lyy622516-web/clock-module/设计报告/48MHz 1分4 时钟信号源模块技术方案与设计报告 龙彦宇 20261021.docx

密 级:内部、华为公司

编 号: CRFICS_FRPT03_20261015

48MHz 1分4 时钟信号源模块技术方案与设计报告

龙彦宇

射频集成电路与系统研究中心

电子科技大学信息与通信工程学院

2026年10月15日

Revision History

Version # | Author | A. Description Of Change B. Summary of Review | Issued By / Date
1.0 | 龙彦宇、文光俊 | 初稿 | 2026年09月20

# 中文摘要（给出关键词）

关键词：

# 英文摘要（给出关键词）

Keywords:

# 一、48MHz时钟参考信号源模块应用场景及研制背景

## 1.1 48MHz时钟参考信号源模块应用场景及研制背景

本模块服务于FTTx（FTTH、FTTB、FTTR等的统称，Fiber to the x）与超高频(Ultra-High Frequency-UHF) RFID融合的无源物联系统的相干增强验证实验。在该类系统中，无源超高频RFID标签（以下简称标签）的接收灵敏度与上行链路预算是制约标签识别距离的关键因素，提升端机向标签方向发射的射频信号强度是增大标签到端机通信距离的有效途径：采用多台超高频无源物联可重构端机（以下简称端机）分布式同时发射射频信号、在目标位置的标签处实现射频信号相干功率合成，可提升目标位置处的接收功率，进而提升系统的覆盖能力与吞吐容量。

设两台端机的载波频率分别为f₁、f₂，初始相位分别为φ₁、φ₂，定义载波频差Δf=f₁−f₂与初始相位差Δφ₀=φ₁−φ₂，则两路发射射频信号的相对相位可表示为Δφ(t)=2πΔf·t+Δφ₀。该式表明：只要Δf≠0，两路信号的相对相位就不会保持固定，而是随时间持续旋转，合成信号幅度随之呈现“增强—相消—增强”的周期性变化，即拍频现象；此时即使某一瞬间两路恰好同相，经过一段时间后也会漂移至90°、180°、270°，无法形成稳定的相干增强。

端机的射频本振由各自板载晶振经锁相环（PLL）产生。若两台端机分别使用独立晶振，即使通过上位机软件配置到同一射频频点，其实际输出频率仍会受晶振频偏、锁相环锁定误差与温度漂移的影响而产生差异，Δf难以控制到足够小，合成增益将随时间周期性起伏。因此，相干增强验证模式下各端机必须共用同一个48MHz参考时钟源。

针对分布式多端机相干信号增强验证实验任务需求，特设计研制FTTx-UHF RFID融合超高频无源物联可重构端机在相干增强验证模式所须的外挂式48MHz参考时钟信号源模块。模块内部产生高频率稳定度、低相位抖动的48MHz削顶正弦（Clipped Sine）信号（基准晶振信号），经一分四Buffer扇出四路同频等幅时钟信号输出（SMA接口）。将48MHz参考时钟信号源模块中4路时钟信号输出端口通过等长同轴电缆与四个端机的外时钟信号输入端口（SMA接口）互联，能同时为四个独立端机输入相参的48MHz 时钟信号（作为其FM13RD1616 超高频RFID 读写芯片中PLL的晶振信号），在四个端机中PLL配置参数等相同条件下，实现分布式布置的4个端机发射的射频信号同频率。

各端机接入公共时钟信号源解决了各端机发射的射频信号“同频”问题，但不保证各端机中锁相环输出的射频信号初相一致（各端机所接时钟信号之间的相位差，以及锁相环锁定时间差、分频比与链路时延差将导致各端机发射的射频信号之间存在随机的相位差），即分布式各端机发射的射频信号同频但不同相（彼此存在相位差）。各端机发射的射频信号初始相位之间的误差，可通过调节端机中射频发射链路中插入的外挂式6bits射频移相器的移相量实现补偿，解决各端机发射的射频信号相位相同问题。

本模块设计采用TCXO产生48MHz、0.8 Vp-p削顶正弦信号作为基准时钟信号，输入1-4 Buffer （一分四式时钟信号分配电路）后，扇出4路同频等幅时钟信号经SMA接口输出。采用低噪声低压差线性稳压器LDO给TCXO、1-4 Buffer独立供电，降低数字噪声、电源噪声等耦合到48MHz本振信号频段，提升时钟参考信号的频谱纯度。

## 1.2 48MHz时钟参考信号源模块功能

本模块功能是产生一路高频率稳定度、低相位抖动的48MHz Clipped Sine信号，经1-4 Buffer后扇出4路同频等幅时钟信号经SMA接口输出。

应用场景要求的本模块功能如下：

1) 独立输出四路48MHz Clipped Sine信号（与各端机中内置的晶振信号特性相同），四路输出的时钟信号频率相同、幅度相等，各时钟信号间的相位差（时间差）尽可能小；
2) 外部直流电源（5V适配器）供电；
3) 独立封装成型。

## 1.3 48MHz时钟参考信号源模块技术指标

拟研制的48MHz时钟参考信号源的主要技术指标如下表1-1所示。

表1-1 48MHz时钟参考源模块技术指标要求

性能参数 | 指标值 | 说明
时钟频率 | 48 MHz | 频率精度由YXC-YSO510TP48M TCXO 性能决定
时钟频率稳定度 | ±2.5ppm
时钟信号波形 | 削顶正弦（Clipped Sine） | 0.8 Vp-p
输出时钟信号路数 | 4路 | SMA接口
各输出时钟信号间时间偏斜量 | 200ps | 由5PB1214 1-4 Buffer芯片性能决定
供电方式 | 5V@1A | USB
工作温度范围 | -55C°~+85C°
贮存温度范围 | -65C°~+150C°

# 二、48MHz时钟参考源模块技术方案及工作原理

## 2.1 48MHz时钟参考源模块总体技术方案

设计的48MHz时钟参考源模块电路架构如图2-1所示，其由48MHz温补晶体振荡器（Temperature Compensated Crystal Oscillator-TCXO）、1:4时钟分配芯片、专用低压差线性稳压器（Low Dropout Regulator-LDO）及输出连接器等构成：48MHz TCXO为频率基准单元，输出0.8 Vp-p的削顶正弦波；5PB1214时钟分配芯片为分配单元，将一路参考信号一分四后送至输出连接器；两片IBSP3030超低噪声LDO为供电单元，分别为TCXO与时钟分配芯片提供低噪声供电。

图2-1 48MHz时钟参考源模块总体技术方案框图

本模块的参考信号链路与供电链路相互独立、各自成链。参考信号链路的流程为：外部直流经直流输入连接器与输入滤波网络送入模块，经两片IBSP3030超低噪声LDO分别稳压后为TCXO与5PB1214时钟分配芯片供电，TCXO起振后输出0.8 Vp-p的削顶正弦（Clipped Sine）参考信号，该信号经隔直与匹配网络送入5PB1214的参考输入端，经芯片内部的输入缓冲级、分配网络与四路输出缓冲级处理后一分四，四路等幅同相的48MHz参考信号分别经隔直元件与SMA连接器输出，供各端机的参考输入端使用。

供电链路的流程为：外部直流经直流输入连接器与输入滤波网络后，分别送入两片IBSP3030的输入端，两片LDO各自稳压后输出3.3 V，其中一片只向TCXO供电，另一片只向5PB1214供电，两路供电在输入滤波、输出储能与接地回流路径上相互独立，并仅在单点实现参考地连接，以避免数字噪声与电源噪声在模块内部形成共地耦合。

本模块的上电与工作流程如下：

（1）外部直流接入后，输入滤波网络对电源纹波与高频噪声进行初步抑制，两片IBSP3030同时启动并输出两路3.3 V电压；

（2）TCXO在获得稳定供电后起振，经内部温度补偿网络校准后输出48MHz、0.8 Vp-p的削顶正弦参考信号；

（3）参考信号经隔直与匹配网络送入5PB1214的参考输入端，经芯片内部缓冲与分配后由四个输出端口等幅同相输出；

（4）四路输出分别经隔直元件与SMA连接器送至各端机的参考输入端，各端机关断板载晶振输出并将该外部参考接入锁相环（Phase Locked Loop-PLL）的参考输入端，各端机据此获得同频的射频载波。

本模块的对外接口与信号定义如下表2-1所示。

表2-1 48MHz时钟参考源模块对外接口与信号定义

接口 / 信号 | 类型 | 电平 / 形式 | 功能说明
直流输入接口 | 电源输入 | 外部直流，电压范围按IBSP3030的输入范围与端机可用电源确定 | 模块供电输入，经输入滤波网络后分别送入两片IBSP3030
参考输出SMA1～SMA4 | 射频输出 | 48MHz、0.8 Vp-p削顶正弦、50 Ω | 四路等幅同相参考输出，供各端机参考输入端使用

## 2.2 48MHz Clipped Sine参考信号的产生

参考信号由温补晶体振荡器（TCXO）产生。TCXO利用石英晶体的谐振特性获得稳定的48MHz振荡频率，并通过内置温度补偿网络减小环境温度变化引起的频率漂移。其输出为削顶正弦波，时域表达式为

v(t)=A cos(2πf_0 t+φ_0 )

式中A为输出幅度，f₀为输出频率（48MHz），φ₀为初始相位。

温补晶体振荡器的频率稳定度由石英谐振器与温度补偿网络共同保证。石英谐振器的谐振频率由晶体切型、尺寸与电极结构决定，其频率—温度特性呈三次曲线，在宽温区内存在数十ppm量级的频率漂移；温度补偿网络将环境温度经热敏元件转换为补偿电压，该电压作用于与晶体串联的变容二极管，通过改变变容二极管的结电容微调谐振回路的等效电抗，对频率—温度特性曲线进行分段拟合与抵消，使振荡频率在−40～+85 ℃温区内保持在±1.0 ppm以内。振荡电路起振后，振荡信号经内部缓冲级放大与限幅后输出，由于输出级的驱动电流受限、输出摆幅同时受电源轨与器件线性工作区限制，波形在波峰与波谷处被削平，形成削顶正弦波。

选用削顶正弦波而非方波或纯正弦波作为参考输出形式，是由端机参考输入端的接口要求决定的：方波信号含有丰富的高次谐波，经端机内部链路后会引入额外的杂散与相位抖动；纯正弦波的输出摆幅与驱动能力有限，经电缆传输后难以保证端机参考输入端的电平要求；削顶正弦波在保留接近正弦的基波成分的同时具有较大的输出摆幅与较强的驱动能力，与端机参考输入端的接口形式一致。

与理想正弦波相比，削顶正弦波的波峰与波谷被削平，因此含有奇次谐波分量，可展开为

v(t)=a_1 cos(2πf_0 t)+a_3 cos(6πf_0 t)+a_5 cos(10πf_0 t)+⋯

式中a₁、a₃、a₅分别为基波与各次谐波的幅度：基波幅度最大，谐波幅度随次数升高而迅速减小。由于参考链路传输的是小幅度模拟信号，谐波成分与基波幅度的关系对分配环节较为敏感，因此分配前后应避免引入非线性与明显的幅度衰减。削顶正弦波示意图如图2-2所示。

削顶正弦波的谐波成分与基波幅度的相对关系，决定了分配环节所能容许的幅度衰减与非线性程度。分配芯片的输入级对输入信号幅度存在一定的工作范围：输入幅度过低会使输出端的信噪比恶化，输入幅度过高或波形在分配前后被再次削顶则会引入额外的奇次谐波、恶化频谱纯度。因此，参考信号在送入分配芯片之前须经隔直与匹配网络，使分配芯片输入端的信号幅度落在其削顶正弦输入所要求的范围以内。

图2-2 削顶正弦波时域波形与谐波分量示意图

## 2.3 参考信号的等幅同相分配

5PB1214时钟分配芯片支持削顶正弦直接输入，可直接完成参考信号的一分四分配。设四路输出分别记为i = 1、2、3、4，其表达式为

5PB1214为1:4时钟分配芯片，其内部由输入缓冲级、内部分配网络与四路输出缓冲级构成。参考信号由参考输入端进入芯片后，先经输入缓冲级完成阻抗变换与电平定标，再由内部分配网络分为四路，分别送入四个结构相同、参数一致的输出缓冲级，经驱动后从四个输出端口输出。由于四路输出由同一片芯片内部、从同一路参考信号分出，并共用同一内部偏置，其频率完全相同，四路之间不存在频率偏差，相对相位不随时间漂移；各输出通道之间的传播延迟差异（即输出间偏斜）主要来源于芯片内部的器件匹配偏差与工艺离散性，在相同负载与相同走线几何条件下，四路输出的幅度偏差与相位偏差可以控制在很小的范围内。

v_i (t)=A_i cos(2πf_0 t+φ_i )

四路输出应满足等幅同相条件

A_i =A,φ_i =φ_0

由于四路输出由同一片分配芯片、从同一路参考信号分出，其频率完全相同，四路之间不存在频率偏差，相对相位不随时间漂移。四路之间的幅度差异与相位差异主要由分配芯片各输出通道的增益偏差与输出间偏斜决定。选用输出间偏斜很低的5PB1214，并保证各输出走线几何条件一致，即可获得良好的等幅同相特性。

为使四路输出满足等幅同相条件，分配环节按下述步骤设计与实施：

（1）选择输出间偏斜指标优良的5PB1214作为分配单元，使芯片内部引入的路间偏差尽可能小；

（2）四路输出采用相同型号、相同容差的隔直元件，并按相同拓扑连接，避免因元件离散性引入额外的幅度与相位差异；

（3）四路输出走线在同一层、等长、等宽布置，并对相邻走线设置地线隔离，使四路走线的分布参数一致；

（4）四路输出端口采用相同的SMA连接器与相同的端接方式，测量时未接入仪器的端口一律以50 Ω匹配负载端接，避免开路或短路引起的反射；

需要说明的是，四路输出之间的相位偏差最终体现为各端机参考输入的到达时刻差，其与射频载波相位差的换算关系为：相位差（度）等于时间偏差（ps）乘以360°，再乘以射频频率（Hz），再除以10的12次方。以48MHz参考信号50 ps的输出间偏斜为例，该偏斜在48MHz参考上对应约0.864°的相位偏差，经端机内部锁相环倍频至922.5 MHz后对应约16.6°的射频相位偏差，该固定相位偏差可由各端机所接6bit数控射频移相器的移相量补偿。

## 2.4 专用LDO独立供电

为避免数字噪声与电源噪声破坏削顶正弦参考信号的频谱纯度，本模块采用两片IBSP3030超低噪声LDO，分别独立为TCXO和5PB1214时钟分配芯片供电。两路供电在输入滤波、输出储能与接地回流路径上相互独立，并仅在单点实现参考地连接。LDO的电源抑制比（Power Supply Rejection Ratio-PSRR）越高，电源纹波经LDO传递到输出端的幅度越小，其关系为

ΔV_o ut=(ΔV_i n)/(10^(PSRR/20))

IBSP3030在100 kHz处的PSRR可达95 dB，可将电源噪声大幅衰减，从而减小对参考信号相位噪声的影响。

电源噪声通过传导耦合与共地阻抗耦合两条路径影响参考信号的频谱纯度。传导耦合路径为开关电源或数字电路的纹波经供电网络直接传递到TCXO与分配芯片的电源引脚，在振荡回路中形成寄生调相；共地阻抗耦合路径为数字电路的开关电流流过公共地线上的寄生电感与电阻，在两地之间形成电位差，该电位差经器件的接地引脚进入振荡回路。两片IBSP3030分别独立供电，使TCXO与分配芯片的供电支路在物理上分开，噪声源与敏感电路之间不再共用同一个电源回路；两路供电仅在单点实现参考地连接，避免了公共地线上形成环流。

专用LDO对电源噪声的抑制能力由电源抑制比（Power Supply Rejection Ratio-PSRR）衡量，其以分贝表示为输入纹波幅度与输出纹波幅度之比的对数值的相反数，PSRR越高，同一输入纹波下传递到输出端的纹波幅度越小。IBSP3030在100 kHz处的PSRR可达95 dB，可将电源噪声大幅衰减，从而减小对参考信号相位噪声的影响。

## 2.5 外挂48MHz同源参考工作原理

只考虑两台端机各自的连续载波，可以分别表示为

s_1 (t)=A_1 cos(2πf_1 t+ϕ_1 )

s_2 (t)=A_2 cos(2πf_2 t+ϕ_2 )

其中, A_1 、A_2 分别为两路载波幅度， f_1 、f_2 为两路载波频率， ϕ_1 、ϕ_2 为初始相位。两路信号合成以后，关键不再只是各自的绝对相位，而是两路信号之间的相对相位。

为了描述两路载波的差异，定义载波频差和初始相位差分别为

Δf=f_2 -f_1

Δϕ_0 =ϕ_2 -ϕ_1

那么随时间变化的相对相位为

Δϕ(t)=2πΔf t+Δϕ_0

这个公式说明：只要 Δf≠0 ,两路载波的相对相位就不会保持固定，而是会随着时间持续旋转。也就是说，即使两台端机在某一个瞬间恰好同相，经过一段时间以后也会变成90°、180°、270°，随后再次回到360°，周而复始。

对于射频相干合成，更直接的幅度关系为

A_Σ (t)=√(A_1^2 +A_2^2 +2A_1 A_2 cos[Δϕ(t)])

若用功率表示，则可以写成

P_Σ (t)=P_1 +P_2 +2√(P_1 P_2)cos(2πΔf t+Δϕ_0 )

因此，当相对相位接近0°时，两路发射射频信号同相叠加，合成功率达到较大值；当相对相位逐渐接近180°时，两路发射射频信号发生相消，合成功率降低；继续演化到360°后又重新同相增强。这样便形成了“增强—相消—增强”的周期性幅度变化，也就是通常所说的拍频现象。

当两路幅度近似相等，即 A_1 =A_2 =A 时，还可以利用三角恒等式将合成信号写成

s_Σ (t)=2Acos(πΔf t+(Δϕ_0)/2)cos(2π(f_1 +f_2)/2t+(ϕ_1 +ϕ_2)/2)

式中第二个余弦项仍然是接近922.5 MHz的高频载波，而第一个余弦项是随 Δf 缓慢变化的幅度因子。如图2-3所示绿色、蓝色和红色波形分别代表端机1的载波、端机2的载波和两台端机的合成信号。

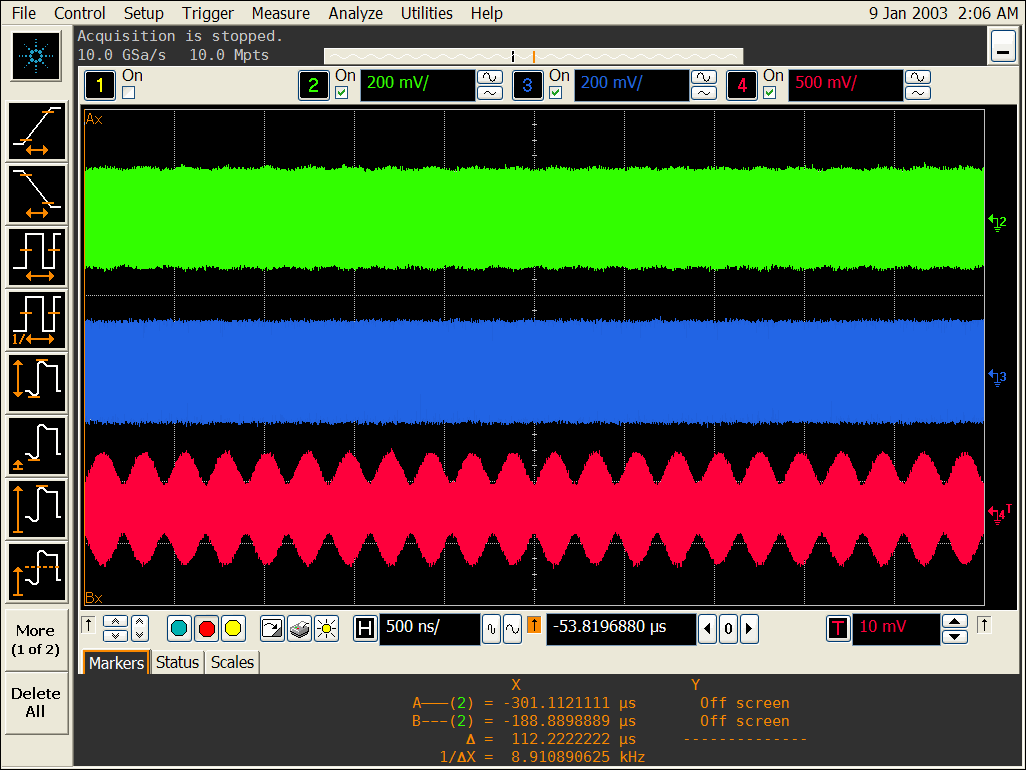
[picture p1: figure]

图2-3 两台端机载波频差引起的拍频现象

端机采用公共48MHz参考时钟的重要意义就在于显著减小不同端机之间的长期频率偏差、使其尽可能为0，但公共参考并不能保证两个端机锁相环输出射频信号的绝对初相天然一致，因此仍需要外挂6bit数控射频移相器进行相位补偿。若两个端机分别使用独立晶振，即使软件配置频点相同，其实际输出频率仍会受晶振频偏和温度漂移影响产生差异。因此，相干增强验证模式下两台端机必须共用一个参考时钟源。

需要指出的是，公共参考源解决的是同频问题，其作用边界在于把各端机之间的载波频差压缩到相干增强实验所允许的范围以内，使两路载波的相对相位在相干时间以内基本保持不变；而两路射频信号到达目标位置处的绝对相位，仍由各端机内部锁相环的锁定过程、分频比、滤波网络、射频电缆与天线的电长度共同决定，属于同相问题，须由各端机所接6bit数控射频移相器解决。

## 2.6 供电能力与功耗分析

本模块的供电结构如图2-1所示：外部直流经USB接口、输入保护与滤波网络后得到内部的VBUS电源，VBUS同时送入两片IBSP3030的输入端，由两片LDO各自独立稳压输出3.3V——U1的输出（电源网络3V3）只向YSO510TP温补晶体振荡器供电，U2的输出（电源网络VDD）只向5PB1214时钟分配芯片供电，两路供电在模块内部互不交叉。该供电结构是否可行，需从压差余量、负载电流与输入电流三个方面核算。

本模块的输入输出电压差为1.7V，而IBSP3030在200mA输出时的典型压差约350mV，1.7V的余量约为该压差的4.8倍；即使计入器件离散性、低温与大电流下压差增大的影响，两片LDO在全工作温度与全负载范围内仍工作在线性调整区，不会进入压差限制状态，因此3.3V输出可以保持稳定，模块无需在USB输入端另加一级稳压。LDO的耗散功率等于压差与输出电流之积，按后述负载电流估算，U1的耗散约6mW、U2的耗散约20～24mW，合计不超过约30mW，两片LDO均不需要额外的散热措施。

两片LDO的负载电流均远低于其200mA的输出能力。TCXO一侧，YSO510TP削顶正弦版本的最大工作电流约3.5mA；缓冲器一侧，5PB1214在3.3V电源、26MHz输入、四路输出全部使能的条件下，电源电流的典型值为11.34mA、最大值为14.06mA（见5PB1214数据手册第5页）。需要指出的是，上述数据是手册在26MHz、四路使能条件下的测试值，本模块工作在48MHz，且外接负载为端机参考输入端或仪器输入等高阻负载，实际电流与手册条件并不完全相同，因此14.06mA只能作为量级参考。

两片LDO的输出能力与模块的输入电流不是同一概念。IBSP3030标称的200mA是器件的输出电流上限，并非模块的实际消耗：每片LDO的输入电流约等于其自身负载电流与静态电流（约3.2mA）之和，两片LDO合计的5V输入电流约为两个负载电流之和再加上两片LDO的静态电流，而不会出现“两片LDO各消耗200mA”的情形。按上述手册值估算，模块的供电电流与供电能力如表2-2所示。

表2-2 模块供电电流与供电能力估算（待实测确认）

项目 | 电流 / 供电能力 | 说明
U1负载：YSO510TP（3.3V） | 最大约3.5mA | 削顶正弦输出，依据TCXO数据手册
U2负载：5PB1214（3.3V） | 典型11.34mA；最大14.06mA | 3.3V、26MHz、四路使能条件（数据手册第5页），48MHz下以实测为准
LDO静态电流（2片） | 单片约3.2mA | 依据IBSP3030数据，两片合计约6.4mA
模块5V输入电流（估算） | 约20mA～25mA | 两个负载电流与两片LDO静态电流之和，待实测确认
供电能力 | 5V@1A | USB适配器供电，输入保险丝X1额定1A

由表2-2可见，模块从5V取用的电流仅约20mA～25mA，相对USB 5V@1A的供电能力与输入保险丝X1的1A额定值均有充足余量，USB供电能力不构成该模块的设计约束；本模块的负载为端机参考输入端这类高阻接收端，负载电流很小，供电能力通常不是瓶颈。

# 三、48MHz时钟参考源模块硬件电路设计与主要器件选型

## 3.1 主要器件选型

### 3.1.1 48MHz TCXO（YSO510TP）

本模块选用扬兴科技（YXC）48MHz温补晶体振荡器（TCXO），型号YSO510TP，其主要技术指标如下表3-1所示。

表3-1 YSO510TP 48MHz TCXO主要技术指标

参数 | 指标
输出频率 | 48 MHz
频率稳定度 | ±1.0 ppm（−40～+85 ℃）
输出波形 | 削顶正弦（Clipped Sine）
输出幅度 | 0.8 Vp-p
工作电压 | 3.3 V
封装 | 3.2 mm × 2.5 mm，4 脚表贴
生产商 | 扬兴科技（YXC）

TCXO是本模块的频率基准，其频率稳定度决定了参考信号的长期频率一致性，其相位噪声决定了参考信号的短时抖动。选用内置温度补偿网络的TCXO，可在宽温区内保持较高的频率稳定度，且体积小、功耗低、启动快。

### 3.1.2 5PB1214时钟分配芯片

时钟分配芯片选用瑞萨科技（Renesas）5PB1214，其主要技术指标如下表3-2所示。

表3-2 5PB1214 1:4时钟分配芯片主要技术指标

参数 | 指标
输入频率 | 0–200 MHz
电源 | 2.5 V / 3.3 V
输入 | LVCMOS / Clipped Sine
封装 | 16-pin，2.5 mm × 2.5 mm VFQFPN
生产商 | 瑞萨科技（Renesas）

5PB1214支持削顶正弦直接输入，与本模块所选TCXO的输出波形一致，可直接完成参考信号的一分四分配，无需额外的波形变换，有利于保持小幅度模拟参考信号的完整性。其四路输出在相同负载与相同走线几何条件下具有很低的输出间偏斜，可保证各输出路之间的等幅同相特性。

### 3.1.3 IBSP3030专用供电LDO

TCXO与时钟分配芯片的专用供电LDO选用英彼森半导体（Inbisen）IBSP3030，其主要技术指标如下表3-3所示。

表3-3 IBSP3030超低噪声LDO主要技术指标

参数 | 指标
输入电压 | 设计建议 2.4～20 V
输出电压 | 0.5～16 V 可调
输出电流 | 200 mA
静态电流 | 约 3.2 mA
PSRR @100 kHz | 95 dB
PSRR @1 MHz | 78 dB
生产商 | 英彼森半导体（Inbisen）

IBSP3030具有很高的电源抑制比与很低的输出噪声，适合为TCXO与时钟分配芯片这类对电源噪声敏感的器件供电。专用LDO可以隔离端机内其他电路（尤其是功放、开关电源）的电源噪声，减小其对参考信号频谱纯度与相位噪声的影响。

## 3.2 原理图设计

本模块的原理图采用层次化方式绘制，按功能划分为顶层框图、时钟一分四部分与电源部分：顶层框图页给出模块的对外接口与页间连接关系，时钟一分四部分给出48MHz参考信号的产生、端接、隔直、偏置、分配与输出电路，电源部分给出模块的取电、保护与稳压电路。

### 3.2.1 48MHz时钟参考源模块电路系统顶层框图

48MHz时钟参考源模块的顶层原理图如图3-1所示。顶层原理图由U_POWER与U_48MHz_TCXO两个层次化图页符号构成，不含具体器件，其作用是表述模块的对外接口以及两页之间的电源关系。U_POWER为电源图页，对外引出USB_5V、3V3与VDD三个层次端口，其中USB_5V为模块的外部直流输入端口，3V3与VDD分别为该页中两片IBSP3030稳压后送出的两路独立电源；U_48MHz_TCXO为时钟一分四图页，输入侧接收U_POWER送来的3V3与VDD两路电源，输出侧引出CLKOUT1～CLKOUT4四路48MHz参考信号。

U_POWER的3V3端口与U_48MHz_TCXO的3V3端口相连，作为48MHz TCXO的专用电源；U_POWER的VDD端口与U_48MHz_TCXO的VDD端口相连，作为5PB1214时钟分配芯片的专用电源。

图3-1 48MHz时钟参考源模块顶层原理图

### 3.2.2 48MHz时钟参考源模块电路原理图设计

本模块的具体电路分布在时钟一分四与电源两页原理图中，两页之间只通过3V3、VDD与USB_5V三组层次端口联系，不共用其他信号线。时钟一分四页完成参考信号的产生、端接、隔直、直流偏置、一分四分配与输出连接；电源页完成Type-C取电、过流与浪涌保护、两路独立稳压及输出滤波。

3.2.2.1 48MHz时钟参考源模块时钟一分四原理图

本模块的时钟一分四原理图如图3-2所示，按信号流程可分为参考信号产生、参考信号调理、一分四分配与四路输出四部分。参考信号由48MHz温补晶体振荡器U4（YSO510TP）产生：U4的第4脚（VDD）接3V3端口，第2脚（GND）接参考地，第1脚（NC）悬空，第3脚（OUTPUT）输出0.8 Vp-p的削顶正弦参考信号。TCXO的供电入口处配置C14（10uF）与C15（100nF）两只去耦电容，分别滤除低频纹波与高频噪声，使TCXO的电源引脚获得低阻抗的供电回路；两只电容的接地端与U4的GND引脚就近汇接后接至参考地，避免去耦电流流过公共地阻抗而形成共地耦合。

U4的输出端并联C16（10pF）、R17（10k）与R18（50Ω）三个对地元件：R18为输出端的50Ω负载端接，使削顶正弦输出工作在额定的负载条件下，C16与R17用于抑制输出端的高频耦合与直流漂移。参考信号再经C11（100nF）隔直后送入5PB1214的参考输入端CLKIN（第15脚）；CLKIN端由R11（10k）接至参考地、R16（10k）接至VDD，两只电阻将隔直后削顶正弦信号的直流工作点偏置在VDD的中点，使输入信号的摆幅落在分配芯片输入级的线性工作范围以内，避免因输入电平过低而使输出信噪比恶化、因输入电平过高而使波形在分配前后被再次削顶。

5PB1214（U3）的电源引脚VDD（第2、7、12脚）接VDD端口，三个电源引脚各自就近配置一组1uF与10nF的去耦电容，即C10与C9、C7与C8、C13与C12，并与VDD支路上的C17（10nF）与C18（1uF）共同构成由大到小的多级滤波网络；芯片的GND引脚（第3、9、14脚）接参考地。四个输出使能端OE1（第16脚）、OE2（第1脚）、OE3（第4脚）与OE4（第5脚）分别经R15、R14、R12、R13上拉至VDD，使四路输出通道在上电后即处于开通状态，避免使能端悬空导致输出通道随机关断；OE_OSC（第6脚）在本设计中悬空未接，参考信号由外部TCXO经CLKIN端输入，不使用芯片内部的振荡单元。

四路输出CLKOUT1（第13脚）、CLKOUT2（第11脚）、CLKOUT3（第10脚）与CLKOUT4（第8脚）分别经串联电阻R19、R20、R21、R22（33Ω）引至SMA连接器H1～H4的中心导体（第1脚）。33Ω串联电阻与分配芯片输出端的等效源阻抗共同构成输出端的串联端接，用于抑制输出波形的过冲与振铃，并把分配芯片的输出与外部电缆隔开，减小电缆侧反射对芯片内部电路的影响；四只SMA连接器的两只接地引脚（第2、3脚）直接接至参考地，使四路输出的参考地回路在连接器处就近汇接。

图3-2 48MHz时钟参考源模块时钟一分四原理图

3.2.2.2 48MHz时钟参考源模块电源原理图

本模块的电源原理图如图3-3所示，按功能可分为Type-C取电与保护、两路独立稳压两部分。模块由USB Type-C插座J1取电，插座的两只外壳引脚EH（第13、14脚）接参考地；CC1与CC2分别经R2、R1（5.1k）下拉至参考地，使插座工作在受电（sink）状态。插座的VBUS引脚并接后先经保险丝X1（1A）实现过流保护，再经瞬态电压抑制二极管D1（SMF5.0A）对浪涌电压进行钳位，随后经C1（47uF）与C2（10uF）组成的输入滤波网络得到模块内部的VBUS电源，供两片LDO使用。

两片IBSP3030分别记为U1与U2，采用完全相同的电路结构，仅输出所连接的电源网络不同。以U1为例：输入引脚IN（第1、2脚）、使能引脚EN/UV（第3脚）与电源正常指示引脚PG（第4脚）均接至VBUS，PG经R5（200k）上拉至EN/UV，使LDO在输入电压建立后自行使能；限流设定引脚ILIM（第5脚）接参考地。U1的输出引脚OUT（第10脚）与OUTS（第9脚）并接后经C3（4.7uF）滤波，由端口3V3输出，在时钟一分四页中为TCXO供电；U2的输入支路配有R9（200k）上拉，其输出由端口VDD输出，为5PB1214时钟分配芯片供电。两片LDO的输入滤波电容、输出储能电容与接地回流路径各自独立，仅在参考地处单点汇接，避免两路供电之间通过公共地阻抗形成耦合。

每片LDO的输出电压由SET端（第7脚）的外接网络设定：SET端经R3（33k）接参考地，并在SET端并联C4（4.7uF），用于旁路SET端的噪声、减小SET端噪声对输出电压与输出噪声的调制；U2对应使用R7与C6。电源正常指示的检测门限由PGFB端（第6脚）设定：PGFB端经R4（91k）接输出电压、经R6（10k）接参考地，由两只电阻对输出电压分压，构成电源正常指示的检测门限；U2对应使用R8与R10。两片LDO的电源正常指示端可用于在调试中判断3V3与VDD两路电源是否均已正常建立。

图3-3 48MHz时钟参考源模块电源原理图

## 3.3 PCB板图设计

本模块的PCB为两层板，板尺寸为22 mm×32 mm。板上器件与48MHz参考信号的走线均布置在L1层（顶层），L2层（底层）为完整的地平面，既为L1层的单端50Ω微带走线提供连续的参考地，也兼作模块的屏蔽与回流平面。

模块PCB的顶层版图如图3-4所示。板面按功能分为三个区域：上侧为电源与接口区，USB Type-C插座位于上侧边，其后依次布置输入保护与滤波元件以及两片IBSP3030及其设定、去耦网络，使USB入口到稳压输出的回路尽量短，减小输入回路的环路面积；中部为时钟产生与分配区，48MHz TCXO及其去耦电容、5PB1214及其各路去耦电容集中布置，缩短了TCXO到分配芯片、分配芯片到各去耦电容的距离；下侧与两侧为输出连接区，四只SMA连接器H1～H4分别布置在板的左侧、右侧与下侧边，四路输出由分配芯片的输出引脚经33Ω串联电阻R19～R22就近引出，串联电阻紧靠分配芯片放置，走线短而直，以减小走线引入的附加损耗、路间串扰与时延差。板面大面积铺参考地，并在SMA连接器的接地引脚与分配芯片的接地引脚周围布置接地过孔，使四路输出的接地回流路径尽量短。

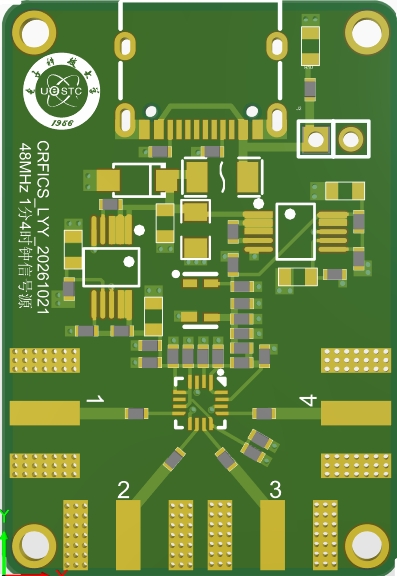
[picture p2: figure]

图3-4 48MHz时钟参考源模块PCB顶层版图

模块PCB的底层版图如图3-5所示。L2层为完整的参考地平面，除连接L1层与L2层的接地过孔外不布置信号走线，从而保证L1层每一段时钟走线的下方均有连续的地平面，避免因参考地不连续引起的阻抗突变与信号反射。底层地平面在SMA连接器与分配芯片的正下方布置了成组的过孔阵列，把L1层的地铜皮、连接器的接地引脚与L2层地平面就近连成同一低阻抗回路，以减小四路输出之间的共地耦合，并为参考信号提供最短的回流路径。

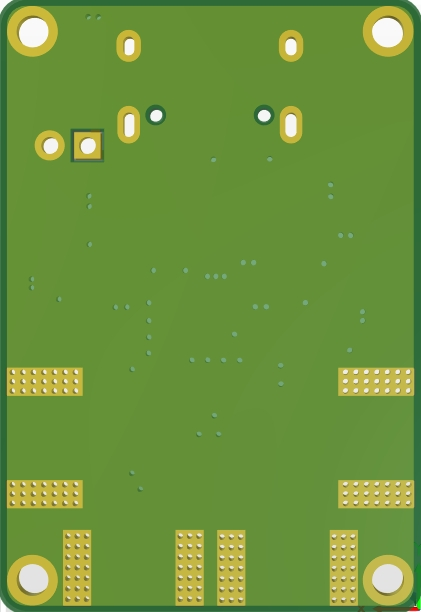
[picture p3: figure]

图3-5 48MHz时钟参考源模块PCB底层版图

模块的层叠结构与厚度如图3-6所示。板材选用Core-034，介质层厚度为0.4064 mm，相对介电常数为4.8，损耗角正切为0.02；L1层与L2层均为1盎司铜，铜厚0.03556 mm；两面的阻焊层厚度均为0.01016 mm。按上述层叠计算，成品板厚约0.5 mm，满足成片厚度不超过0.6 mm的要求。选用较薄的介质与较薄的成品板厚，一方面使L1层50Ω微带线的线宽落在便于加工、焊接与阻抗控制的范围内，另一方面缩短了接地过孔的路径长度，有利于降低四路输出端的接地电感。

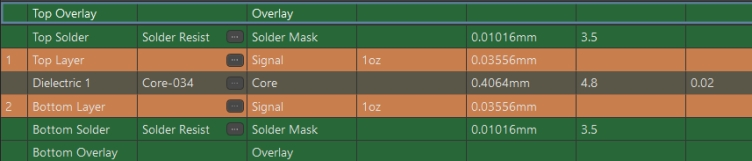
[picture p4: figure]

图3-6 48MHz时钟参考源模块PCB层叠结构

48MHz参考信号的输出走线按单端50Ω阻抗控制。按上述层叠参数计算，L1层单端50Ω微带线的线宽取0.661 mm，走线以L2层地平面为参考面，使四路输出走线的特性阻抗与SMA连接器的50Ω接口相匹配，减小因阻抗失配引起的反射。四路输出从5PB1214的输出引脚经33Ω串联电阻后就近引出至SMA连接器，走线尽量短、尽量直，并保持与相邻走线足够的间距，以减小走线间的串扰与附加时延；由于四只SMA连接器分布在板的三侧，四路走线的长度不能完全相等，其引入的路间时延差以实测值为准，测试时与分配芯片的输出间偏斜一并计入。

# 四、48MHz时钟参考源模块加工与装配方案

## 4.1 加工方案

本模块的加工对象包括印制板（Printed Circuit Board-PCB）、结构件与连接器，其加工方案的确定以原理图与板图定版为前提。

## 4.2 装配方案

# 五、48MHz时钟参考源模块功能与性能调试与测试方案

本模块的调试与测试围绕其作为相干增强验证公共参考源的功能定位展开。模块需要解决的问题是：为多台端机提供频率一致、幅度与相位关系可复现的48MHz参考信号，从而把各端机之间的载波频差压缩到相干增强实验所允许的范围以内。

## 5.1 调测平台与仪器配置

### 5.1.1 测试仪器与设备清单

本模块的输出为小幅度削顶正弦波，测量以频域测量为主、时域测量为辅。所有射频端口均应通过50Ω同轴线缆与SMA转接器连接，并在使用前记录线缆损耗；测量相位关系时应避免使用带宽不足或输入阻抗不匹配的仪器直接跨接。所需仪器设备如下表5-1所示。

表5-1 测试仪器与设备清单

序号 | 仪器 / 设备名称 | 主要技术要求 | 用途
1 | 频谱分析仪 | 频率范围覆盖48MHz，具备相位噪声测量选件 | 输出频率、谐波与杂散测量
2 | 信号源分析仪/相位噪声测试仪 | 支持48MHz载波，偏置频率覆盖1kHz～1MHz | 相位噪声测量，可用带相位噪声选件的频谱分析仪替代
3 | 数字示波器 | 带宽不低于1GHz，不少于4通道，通道间偏斜可标定 | 输出幅度、波形与四路输出间相位偏差测量
4 | 矢量网络分析仪 | 频率范围覆盖48MHz附近 | 输出端口回波损耗与路间隔离度测量
5 | 可编程直流稳压电源 | 输出电压覆盖模块输入范围，具备电压与电流读数 | 模块供电与电流、功耗测量

### 5.1.2 被测模块与测试连接关系

被测模块为48MHz时钟参考源模块样机，测试时由可编程直流稳压电源经外部直流输入端供电。四路SMA参考输出中，一路接频率计数器，一路接频谱分析仪或信号源分析仪，两路接数字示波器通道，其余端口以50Ω匹配负载端接，避免开路反射。测量四路输出之间的相位偏差时，四路输出应同时接入示波器的四个通道，并预先完成通道偏斜标定。

本阶段给出测试方案与测量方法，测试连接框图待样机加工与装配完成后补充，图中应标明各仪器型号、线缆编号、端接方式与测试端口。

## 5.2 供电与静态工作点测试

供电部分的测试目标是确认两片IBSP3030能够按设计分别为TCXO与时钟分配芯片提供稳定的3.3V供电，并核验模块整体功耗是否处于预算范围以内。为TCXO与分配芯片独立供电是抑制电源噪声、保证参考信号频谱纯度的关键措施，因此除电压数值外，还须关注输出电压上的纹波与开关噪声。

## 5.3 参考频率与频率稳定度测试

参考频率的准确度与稳定度是本模块最核心的指标。公共参考源的作用是把各端机之间的载波频差压缩到相干增强实验所允许的范围以内，因此除标称48MHz处的频率偏差外，还须考察频率随时间与温度的变化。按照表1-1，参考频率精度由TCXO决定，所选YSO510TP的频率稳定度为±1.0 ppm（−40～+85 ℃），该指标构成本节各测试项目的判据来源。

## 5.4 输出电平与波形质量测试

参考信号的输出电平与波形质量决定了它能否与端机TCXO参考输入端的接口要求相匹配。本模块输出为0.8 Vp-p的削顶正弦波，幅度偏低，测量时应特别注意仪器的输入阻抗与耦合方式，频谱分析仪测量谐波与杂散时应避免输入过载。

### 5.4.1 削顶正弦波形与谐波分量测试

用示波器观察单一周期内的波形形态，确认波峰与波谷被对称削平，无畸变、无自激与明显的幅度抖动。削顶正弦波本身含有奇次谐波分量，其谐波幅度随次数升高而迅速减小，可用频谱分析仪测量二次、三次谐波相对基波的抑制度，作为波形完整性的量化依据。由于参考链路传输的是小幅度模拟信号，谐波成分与基波幅度的关系对分配环节较为敏感，分配前后不应引入额外的非线性与明显的幅度衰减；若测试中发现谐波抑制度明显恶化，应检查分配芯片的输入电平与阻抗匹配状态。

### 5.4.2 四路输出幅度一致性测试

在同一批次、同一示波器设置下测量四路输出的幅度，取最大值与最小值之差作为路间幅度不一致度并以dB表示。等幅是四路输出应满足的条件之一，路间幅度差异主要来源于分配芯片各输出通道的增益偏差与输出走线的不一致。测试结果应记录并作为后续各端机参考输入电平一致性的依据。

## 5.5 四路输出等幅同相特性测试

四路输出之间的相位偏差直接叠加到各端机的参考输入上，进而影响各端机锁相环输出射频信号的初相差异。该偏差量级较小，测量时必须先扣除测量系统本身的通道偏斜，否则通道偏斜会被误判为模块的输出间相位偏差。

## 5.6 相位噪声测试

将任一路参考输出接入具备相位噪声测量能力的仪器，在1 kHz、10 kHz、100 kHz、1 MHz等偏置频率处测量单边带相位噪声。测量前应确认仪器的本底噪声低于被测信号的预期相位噪声，必要时在仪器输入端串联衰减器以保护输入。

## 5.7 端机联调验证测试

模块自身指标合格并不等于公共参考源在系统中有效。公共参考源只解决同频问题，并不能保证两套锁相环输出的射频初相天然一致，因此联调验证的目标是在模块接入两台端机之后，实测其载波残余频差是否已落入相干增强实验所允许的范围。

两台端机共用一个48MHz参考源并配置在同一射频频点，在固定目标接收点、相同测量通路与带宽下测量单路功率，随后两路同时发射，在频谱仪或矢量信号分析仪上观测合成信号包络的拍频周期，据此反推两路端机之间的载波残余频差，并计算相干增强可保持的相干时间。该残余频差的实测结果是判断相干增强可保持时长、进而确定移相码搜索与更新周期的关键输入。

# 六、48MHz时钟参考源模块测试及结果

本模块当前处于方案与工作原理分析阶段，尚未完成样机加工与装配，本章给出测试记录方法与记录表，待样机加工、装配和联调完成后，将每次测试的日期、地点、温湿度、样机编号、软件版本、仪器型号、线缆损耗、频点、功率、RSSI和结论填入测试报告，并附原始数据或截图。

## 6.1 测试记录表

表中空白处为实测填写区，测试时应同时保存仪器截图或原始数据文件，不得以设计值或理论值代替实测记录。

表6-1 供电与静态工作点测试记录表（待测）

测试项目 | 设计要求 / 判据 | 实测值 | 结论 | 备注
直流输入电压 | 按模块输入设计值
TCXO供电电压（IBSP3030输出1） | 3.3 V
分配芯片供电电压（IBSP3030输出2） | 3.3 V
模块总电流 / 总功耗 | 在设计预算范围以内

表6-2 四路输出幅度测试记录表（待测）

输出路 | 实测幅度（Vp-p） | 设计值（Vp-p） | 幅度偏差 | 波形形态 | 备注
输出1 | | 0.8
输出2 | | 0.8
输出3 | | 0.8
输出4 | | 0.8
路间幅度不一致度 | | — | | —

表6-3 相位噪声与杂散测试记录表（待测）

偏置频率 | 独立LDO供电（dBc/Hz） | 直接供电（dBc/Hz） | 备注
1kHz
10kHz
100kHz
1MHz
最大非谐波杂散

## 6.2 测试结论

当前阶段尚未完成样机加工与装配，各项测试数据待样机联调完成后填入上述记录表并据此形成结论。结论中应明确受测样机编号、测试日期、测试地点、仪器型号与校准状态，并对未达标项给出原因定位与下一轮改进措施。

# 七、总结

本模块面向FTTx与超高频RFID融合无源物联系统的相干增强验证需求，研制了一路高频率稳定度、低相位抖动的48MHz公共参考源。模块以YSO510TP温补晶体振荡器为频率基准，输出0.8 Vp-p的削顶正弦波，经5PB1214时钟分配芯片完成一分四分配后通过SMA连接器输出，供多台可重构端机共用；两片IBSP3030超低噪声LDO分别为TCXO与时钟分配芯片独立供电，以减小电源噪声对参考信号频谱纯度与相位噪声的影响。

该方案种公共参考源解决的是相干增强中“同频”的问题。只要两台端机之间存在载波频差，两路发射射频信号的相对相位就会随时间持续旋转，合成信号幅度随之呈现增强—相消—增强的周期性变化，即拍频现象；即使某一瞬间恰好同相，经过一段时间后也会漂移至90°、180°、270°。采用公共48MHz参考能够显著减小不同端机之间的长期频率偏差，但并不能保证两套锁相环输出的射频初相天然一致，因此同频与同相两个问题需分别解决，本模块与外挂6bit数控射频移相器模块配合使用。

本模块目前处于技术方案与工作原理分析阶段，电路原理图与PCB板图尚未绘制，加工与装配方案、样机实测数据待后续补充。

# 附件：引用的技术文献清单

1) 元器件/芯片datasheet清单
（1） 48MHz时钟参考模块datasheet
2) 应用的设计开发平台文档清单
（1） Altium Designer 25
（2） Matlab2016

13 Not for use or disclosure outside CRFICS，SICE，UESTC. except under prior written agreement
