lyy622516-web/clock-module/设计报告/48MHz Clipped Sine 时钟信号产生技术方案与设计报告 井家轩 20260911.docx

密 级

编 号

48MHz时钟参考源模块技术方案与设计报告

姓 名

井家轩

射频集成电路与系统研究中心

电子科技大学信息与通信工程学院

2026年09月11日

Revision History

Version # | Author | A. Description Of Change B. Summary of Review | Issued By / Date
1.0 | 井家轩 | 初稿 | 2026年09月10日

目 录

# 中文摘要（给出关键词）

# 英文摘要（给出关键词）

# 一、外挂时钟参考模块功能与技术指标要求

本模块的功能是产生一路高频率稳定度、低相位抖动的 48 MHz Clipped Sine（削顶正弦）参考时钟信号，并将其等幅同相地分配到各端机的参考输入端。

本模块要实现的具体功能及应用场景与要求如下：

（1）产生 48 MHz 参考时钟信号，输出波形为削顶正弦（Clipped Sine）波，与端机 TCXO 参考输入端的接口形式一致；

（2）参考信号经时钟分配芯片完成一分四分配，各输出路之间保持等幅同相；

（3）模块采用外部直流供电，由专用 LDO 稳压后分别为 TCXO 与时钟分配芯片供电；

（4）模块置于独立结构内，通过连接器引出参考信号，便于与各端机互连。

依据任务需求与端机参考输入端的接口要求，本模块应达到的主要技术指标如下表所示。

指标项目 | 设计值 / 目标值 | 说明
参考频率 | 48 MHz | 单路公共参考，频率精度由 TCXO 决定
输出波形 | 削顶正弦（Clipped Sine） | 0.8 Vp-p，与端机 TCXO 参考输入端一致
输出路数 | 1:4 | 由 5PB1214 时钟分配芯片完成分配
输出间相位偏差 | 尽量小 | 由分配芯片的输出间偏斜决定
供电方式 | 外部直流输入 + 专用 LDO 独立供电 | TCXO 与分配芯片分别独立供电
TCXO 供电电压 | 3.3 V | 由 IBSP3030 输出设定
分配芯片供电电压 | 3.3 V | 由 IBSP3030 输出设定
输出端口形式 | SMA | 便于与端机互连

# 二、外挂时钟参考模块技术国内外研究进展与趋势

# 三、48MHz Clipped Sine时钟信号产生技术方案及工作原理

## 3.1 总体技术方案

本模块采用"TCXO 产生参考频率 + 时钟分配芯片完成等幅同相分配 + 专用 LDO 独立供电"的三段式架构，由 48 MHz TCXO、1:4 时钟分配芯片、专用 LDO 和输出连接器组成。

48 MHz TCXO 为频率基准单元，输出 0.8 Vp-p 的削顶正弦波；5PB1214 时钟分配芯片为分配单元，把一路参考信号一分四后送至输出连接器；两片 IBSP3030 专用 LDO 为供电单元，分别为 TCXO 与时钟分配芯片提供低噪声供电。由于 TCXO 输出为小幅度模拟信号，参考链路应保持削顶正弦形式，分配前后不应引入明显的幅度衰减或波形变换。

## 3.2 48 MHz Clipped Sine 参考信号的产生

参考信号由温补晶体振荡器（TCXO）产生。TCXO 利用石英晶体的谐振特性获得稳定的 48 MHz 振荡频率，并通过内置温度补偿网络减小环境温度变化引起的频率漂移。其输出为削顶正弦波，时域表达式为

v(t)=A cos(2πf_0 t+φ_0 )

式中 A 为输出幅度，f₀ 为输出频率（48 MHz），φ₀ 为初始相位。

与理想正弦波相比，削顶正弦波的波峰与波谷被削平，因此含有奇次谐波分量，可展开为

v(t)=a_1 cos(2πf_0 t)+a_3 cos(6πf_0 t)+a_5 cos(10πf_0 t)+⋯

式中 a₁、a₃、a₅ 分别为基波与各次谐波的幅度。基波幅度最大，谐波幅度随次数升高而迅速减小。由于参考链路传输的是小幅度模拟信号，谐波成分与基波幅度的关系对分配环节较为敏感，因此分配前后应避免引入非线性与明显的幅度衰减。

## 3.3 参考信号的等幅同相分配

5PB1214 支持削顶正弦直接输入，可直接完成参考信号的一分四分配。设四路输出分别记为 i = 1、2、3、4，其表达式为

v_i (t)=A_i cos(2πf_0 t+φ_i )

四路输出应满足等幅同相条件

A_i =A,φ_i =φ_0

由于四路输出由同一片分配芯片、从同一路参考信号分出，其频率完全相同，四路之间不存在频率偏差，相对相位不随时间漂移。四路之间的幅度差异与相位差异主要由分配芯片各输出通道的增益偏差与输出间偏斜决定。选用输出间偏斜很低的 5PB1214，并保证各输出走线几何条件一致，即可获得良好的等幅同相特性。

## 3.4 专用 LDO 独立供电

为避免数字噪声与电源噪声破坏削顶正弦参考信号的频谱纯度，本模块采用两片 IBSP3030 超低噪声 LDO，分别独立为 TCXO 和 5PB1214 时钟分配芯片供电。两路供电在输入滤波、输出储能与接地回流路径上相互独立，并仅在单点实现参考地连接。

LDO 的电源抑制比（PSRR）越高，电源纹波经 LDO 传递到输出端的幅度越小，其关系为

ΔV_o ut=(ΔV_i n)/(10^(PSRR/20))

IBSP3030 在 100 kHz 处的 PSRR 可达 95 dB，可将电源噪声大幅衰减，从而减小对参考信号相位噪声的影响。

# 四、外挂时钟参考模块软硬件设计与仿真

# 五、硬件设计与主要器件选型

## 5.1 器件选型

### 5.1.1 48 MHz TCXO

本模块选用 48 MHz 温补晶体振荡器（TCXO），型号 YSO510TP，其主要技术指标如下表所示。

参数 | 指标
输出频率 | 48 MHz
频率稳定度 | ±1.0 ppm（−40～+85 ℃）
输出波形 | 削顶正弦（Clipped Sine）
输出幅度 | 0.8 Vp-p
工作电压 | 3.3 V
封装 | 3.2 mm × 2.5 mm，4 脚表贴
生产商 | 扬兴科技（YXC）

TCXO 是本模块的频率基准，其频率稳定度决定了参考信号的长期频率一致性，其相位噪声决定了参考信号的短时抖动。选用内置温度补偿网络的 TCXO，可在宽温区内保持较高的频率稳定度，且体积小、功耗低、启动快。

### 5.1.2 5PB1214 时钟分配芯片

时钟分配芯片选择 5PB1214，其主要技术指标如下表所示。

参数 | 指标
输入频率 | 0–200 MHz
电源 | 2.5 V / 3.3 V
输入 | LVCMOS / Clipped Sine
封装 | 16-pin，2.5 mm × 2.5 mm VFQFPN
生产商 | 瑞萨科技（Renesas）

5PB1214 支持削顶正弦直接输入，与本模块所选 TCXO 的输出波形一致，可直接完成参考信号的一分四分配，无需额外的波形变换，有利于保持小幅度模拟参考信号的完整性。其四路输出在相同负载与相同走线几何条件下具有很低的输出间偏斜，可保证各输出之间的等幅同相特性。

### 5.1.3 IBSP3030 专用供电 LDO

TCXO 与时钟分配芯片的专用供电 LDO 选择 IBSP3030，其主要技术指标如下表所示。

参数 | 指标
输入电压 | 设计建议 2.4～20 V
输出电压 | 0.5～16 V 可调
输出电流 | 200 mA
静态电流 | 约 3.2 mA
PSRR @100 kHz | 95 dB
PSRR @1 MHz | 78 dB
生产商 | 英彼森半导体（Inbisen）

IBSP3030 具有很高的电源抑制比与很低的输出噪声，适合为 TCXO 与时钟分配芯片这类对电源噪声敏感的器件供电。专用 LDO 可以隔离端机内其他电路（尤其是功放、开关电源）的电源噪声，减小其对参考信号频谱纯度与相位噪声的影响。

## 5.2 供电与接地方案

本模块采用外部直流输入，经两片 IBSP3030 分别稳压后为 TCXO 与时钟分配芯片供电。两路供电在输入端分别设置独立的滤波网络，输出端分别设置独立储能电容，接地采用单点参考地连接，以减小两路之间的相互干扰。

## 5.3 参考信号的分配与传输

TCXO 输出的 48 MHz 削顶正弦参考信号送入 5PB1214 的输入端，经一分四分配后由多路输出分别送至连接器，再通过同轴线缆连接至各端机的 TCXO 参考输入端。分配芯片输出端可按数据手册要求串联端接电阻，以改善信号完整性与端口匹配。各输出线缆应保持等长、同型号、同连接器，并远离功放、驱动放大器和开关电源。

## 5.4 原理图设计

本阶段给出方案与工作原理分析，器件的具体连接关系、外围元件参数取值与原理图（Protel Schematic）绘制将后续采用Protel 平台进行设计。原理图设计应遵循以下要点：TCXO 与分配芯片分别由专用 LDO 独立供电；分配芯片每个电源引脚就近放置旁路电容；参考输入/输出按 50 Ω 设计，走线尽量短而直；模拟参考信号与数字、电源信号分区布置。

# 六、外挂时钟参考模块加工方案

# 七、外挂时钟参考模块装配方案

# 八、外挂时钟参考模块功能与性能调试与测试方案

# 九、外挂时钟参考模块测试及结果

# 十、总结

# 十一、外挂时钟参考模块使用说明书

# 十二、其他说明

# 十三、引用的技术文献清单

13 Not for use or disclosure outside CRFICS，SICE，UESTC. except under prior written agreement
