lyy622516-web/clock-module/腔体/四孔法兰新腔体/分类交付/底座_初稿.SLDPRT

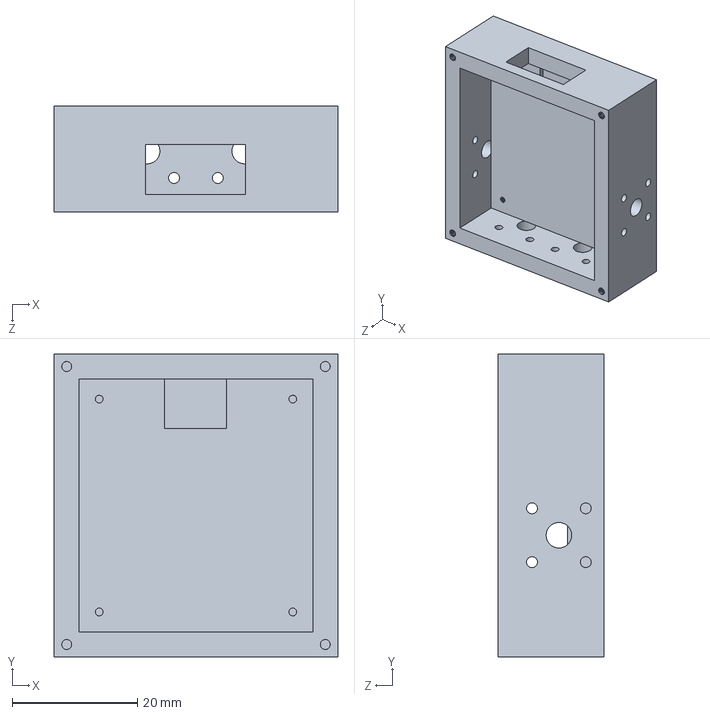
[picture p31: CAD file, 2026-11-03]
腔体/四孔法兰新腔体/分类交付/底座_初稿.SLDPRT
45.3 x 48.5 x 17.0 mm
