lyy622516-web/clock-module/腔体/3D_48MHz1-4_TCXO_2026-10-30.step

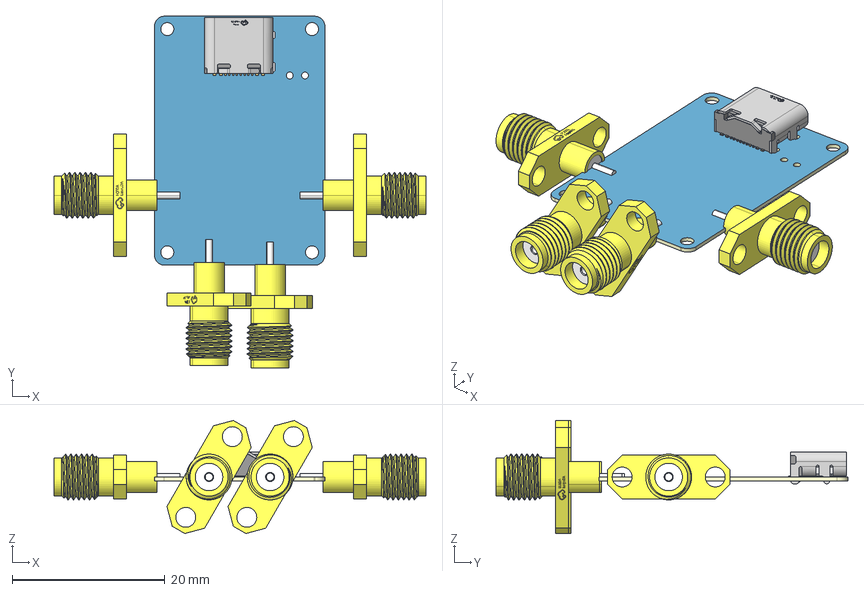
[picture p32: CAD file, 2026-10-31]
腔体/3D_48MHz1-4_TCXO_2026-10-30.step
48.7 x 46.1 x 14.8 mm
Board~5I7d
TopCopper~5I7d
BottomCopper~5I7d
TopSilkscreen~5I7d
BottomSilkscreen~5I7d
TopFpcStiffener~5I7d
BottomFpcStiffener~5I7d
SMA-SMD~CONN-TH_HL-SMA-KFD1011~Jz3e x 4
TYPEC_16PIN~USB-C-SMD_TYPE-C-6PIN-2MD-073~BUdh
