lyy622516-web/clock-module/腔体/零件1.SLDPRT

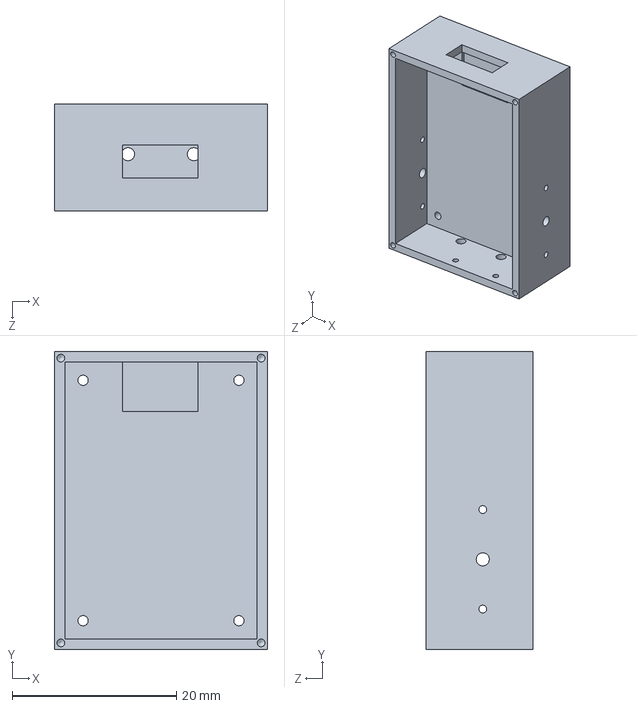
[picture p33: CAD file, 2026-10-31]
腔体/零件1.SLDPRT
26.0 x 36.2 x 13.0 mm
