lyy622516-web/clock-module/腔体/零件2.SLDPRT

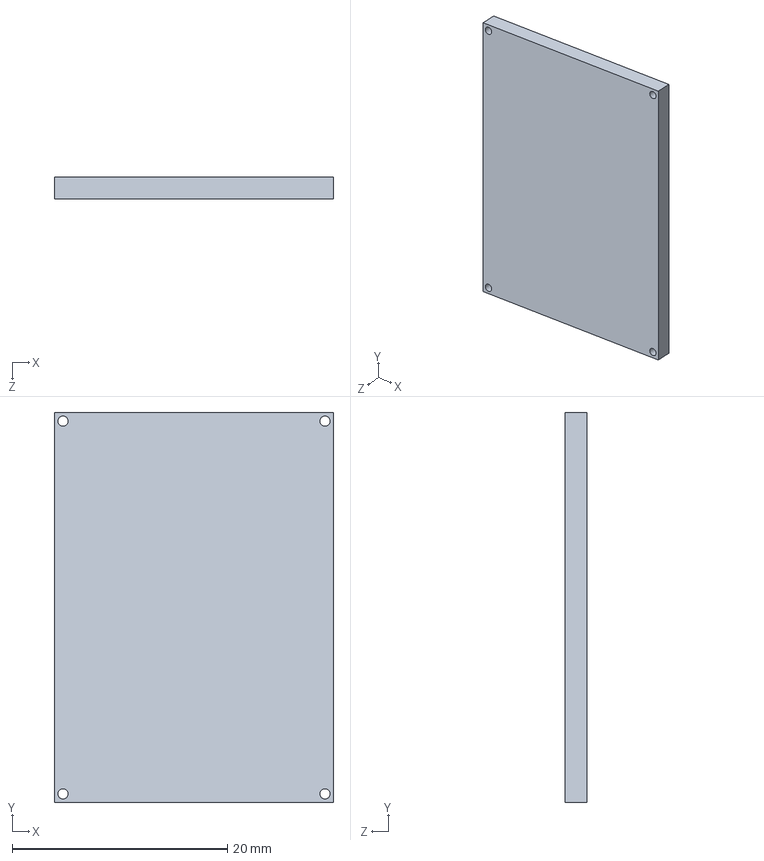
[picture p34: CAD file, 2026-10-31]
腔体/零件2.SLDPRT
25.9 x 36.2 x 2.00 mm
