lyy622516-web/clock-module/腔体/装配体1.SLDASM

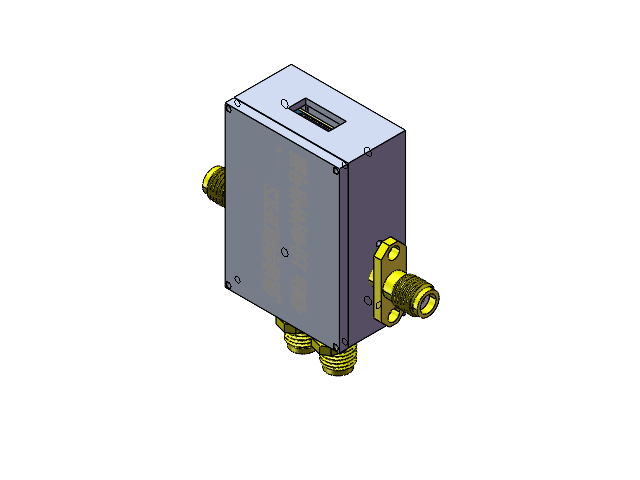
[picture p35: CAD file, 2026-10-31]
腔体/装配体1.SLDASM
SMA-SMD~CONN-TH_HL-SMA-KFD1011~Jz3e.step x 4
TYPEC_16PIN~USB-C-SMD_TYPE-C-6PIN-2MD-073~BUdh.step
Board~5I7d.step
零件1
零件2
