lyy622516-web/clock-module/(list of files, cad)

Other CAD files:
腔体/四孔法兰新腔体/分类交付/底座_初稿.SLDDRW
腔体/四孔法兰新腔体/分类交付/盖板.SLDDRW
腔体/零件1.SLDDRW
腔体/零件2.SLDDRW
