lyy622516-web/clock-module/48MHz_timer/48MHz_timer/48MHz_timer.pdf

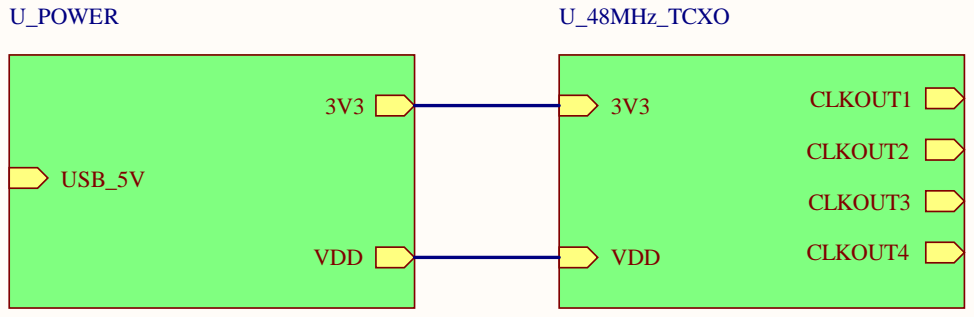
[picture p36: page 1]

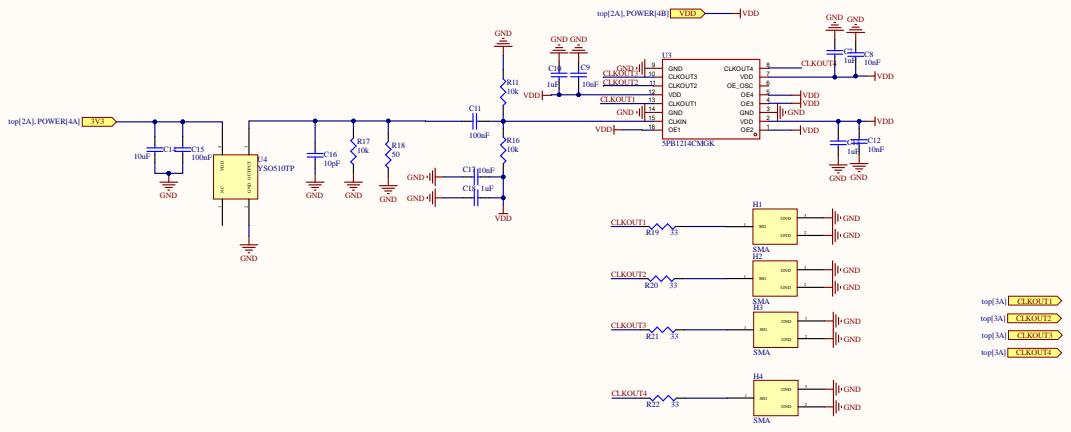
[picture p37: page 2]

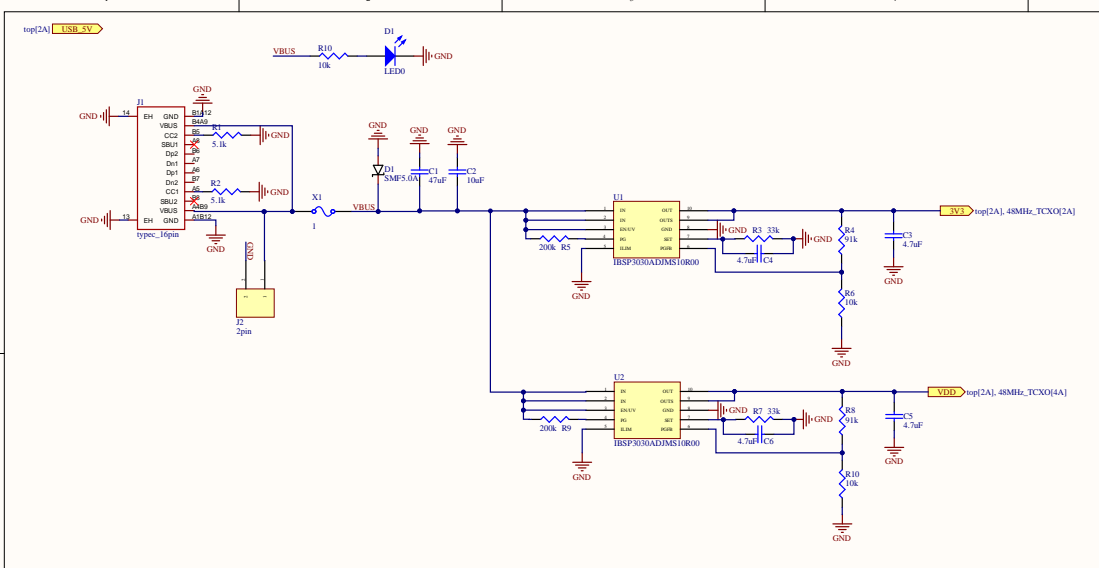
[picture p38: page 3]
