lyy622516-web/clock-module/腔体/四孔法兰新腔体/分类交付/工程图.pdf

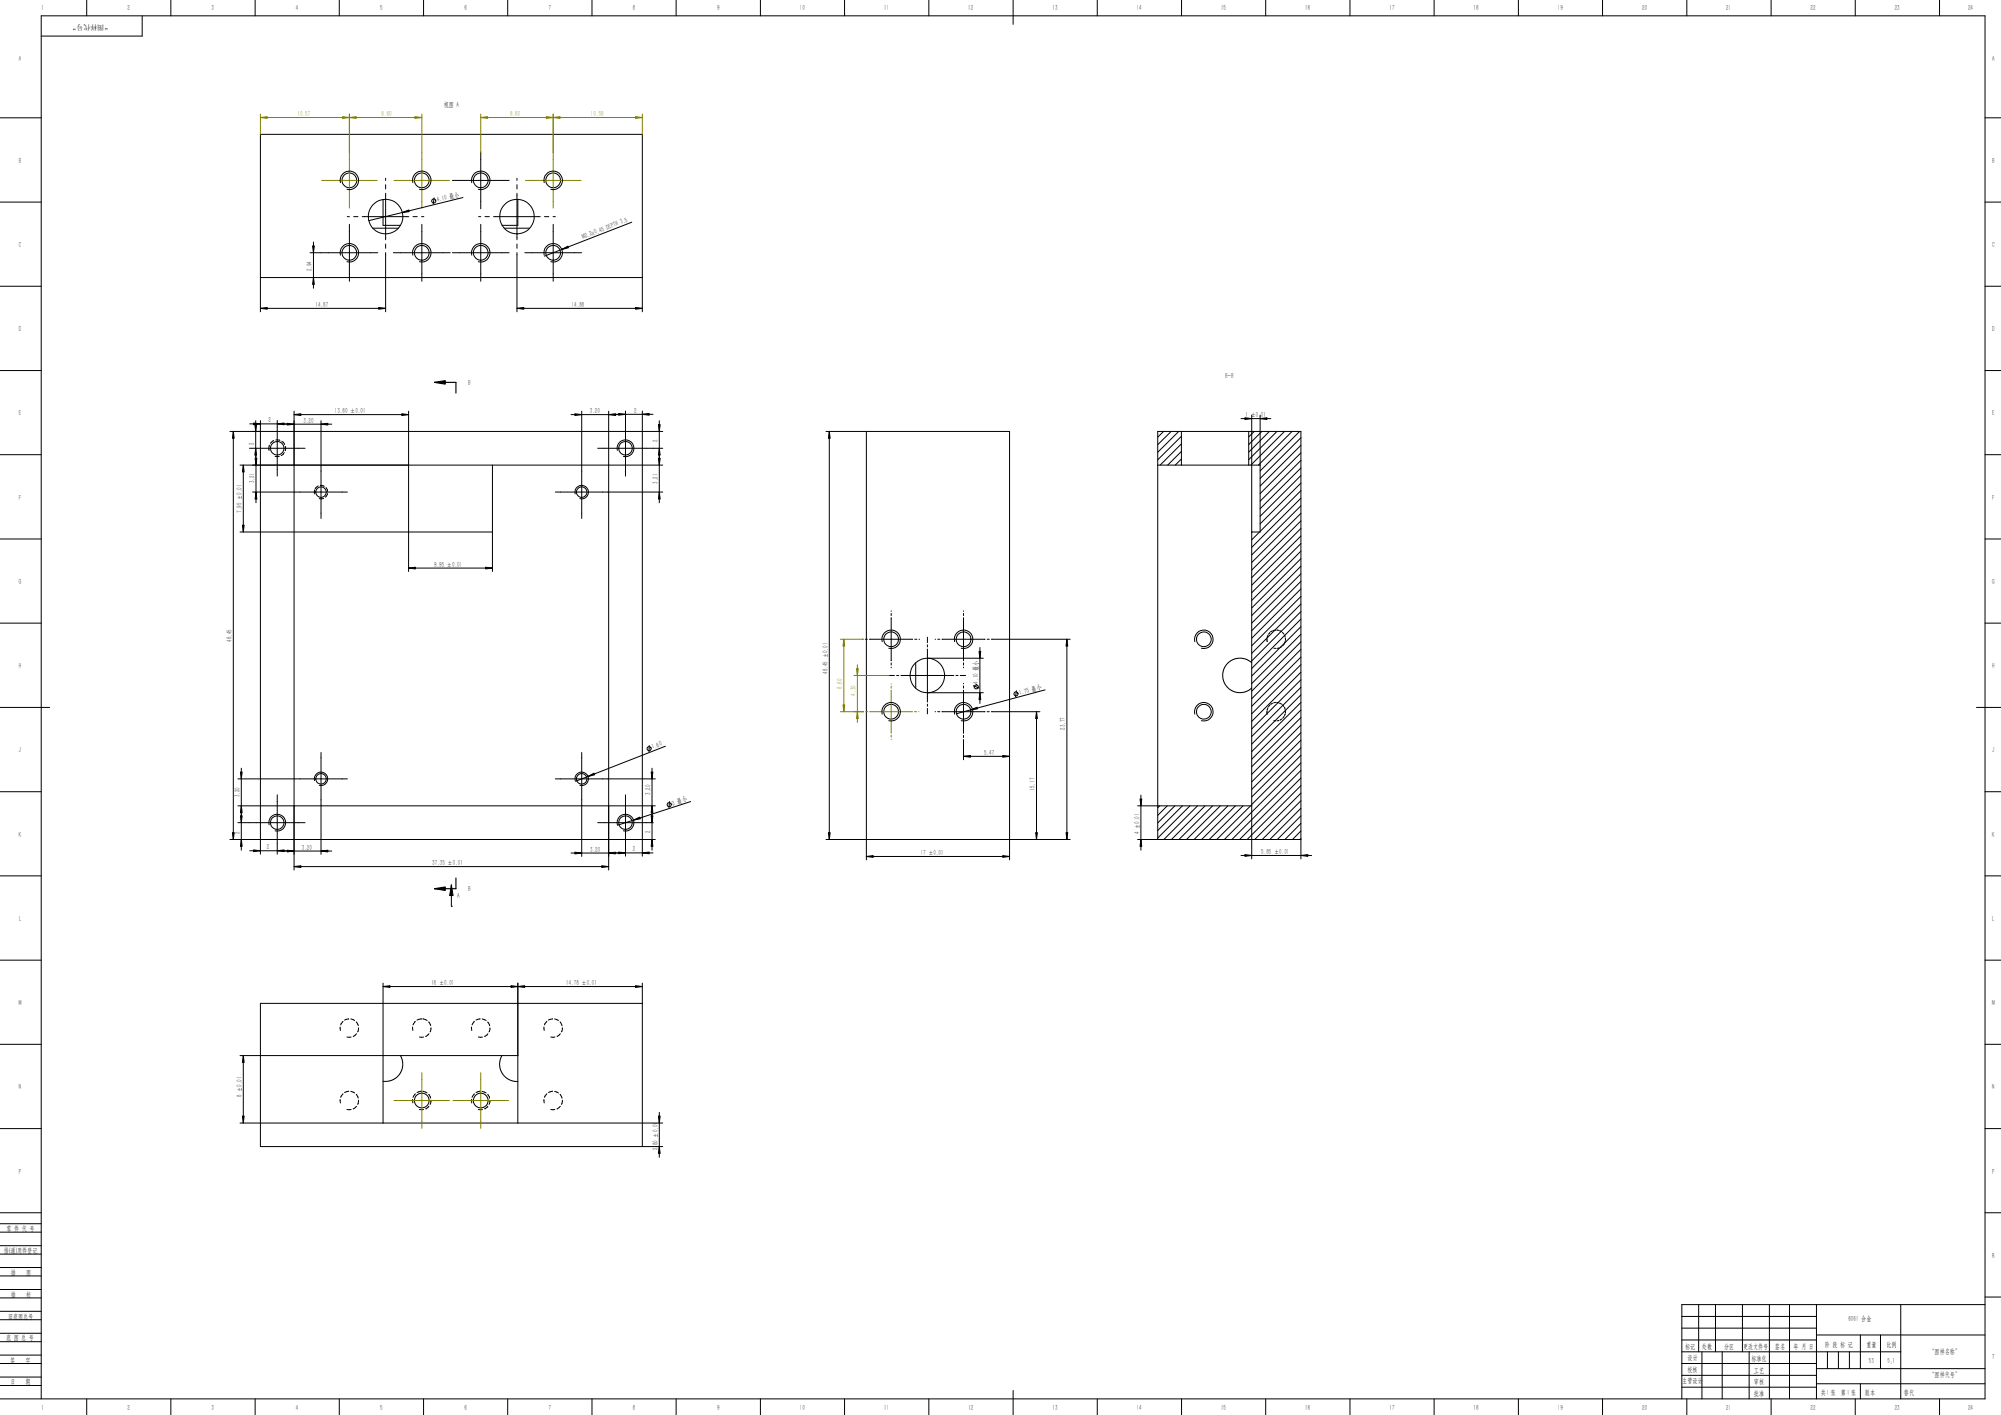
[picture p39: page 1]
旧底图总号; 借(通)用件登记; M2.2x0.45 DEPTH 3.5 8 ±0.01

标记 | 处数 | 分区 | 更改文件号 | 签名 | 年 月 日

阶 段 标 记 | 重量 | 比例 | “图样名称”

设计 | | | 标准化 | | | 53 | 5:1
校核 | | | 工艺
主管设计 | | | 审核

“图样代号”
