lyy622516-web/clock-module/(list of files, drawings)

Other design files:
48MHz 1分4 时钟信号源模块加工文档/48MHz1-4_TCXO.PcbDoc
48MHz_timer/48MHz_timer/48MHz1-4_TCXO.PcbDoc
48MHz_timer/48MHz_timer/48MHz_TCXO.SchDoc
48MHz_timer/48MHz_timer/48MHz_timer.PrjPcb
48MHz_timer/48MHz_timer/BaseStation.PcbLib
48MHz_timer/48MHz_timer/BaseStation_1.SCHLIB
48MHz_timer/48MHz_timer/BS_RFE_BB_20230506.PcbLib
48MHz_timer/48MHz_timer/lichuang/Altium_5PB1214CMGK8_2026-09-29/5PB1214CMGK8/5PB1214CMGK8.pcbdoc
48MHz_timer/48MHz_timer/lichuang/Altium_5PB1214CMGK8_2026-09-29/5PB1214CMGK8/5PB1214CMGK8.PrjPcb
48MHz_timer/48MHz_timer/lichuang/Altium_5PB1214CMGK8_2026-09-29/5PB1214CMGK8/5PB1214CMGK8/5PB1214CMGK8.schdoc
48MHz_timer/48MHz_timer/lichuang/Altium_IBSP3030ADJMS10R00_2026-09-29/IBSP3030ADJMS10R00/IBSP3030ADJMS10R00.pcbdoc
48MHz_timer/48MHz_timer/lichuang/Altium_IBSP3030ADJMS10R00_2026-09-29/IBSP3030ADJMS10R00/IBSP3030ADJMS10R00.PrjPcb
48MHz_timer/48MHz_timer/lichuang/Altium_IBSP3030ADJMS10R00_2026-09-29/IBSP3030ADJMS10R00/IBSP3030ADJMS10R00/IBSP3030ADJMS10R00.schdoc
48MHz_timer/48MHz_timer/PcbLib1.PcbLib
48MHz_timer/48MHz_timer/POWER.SchDoc
48MHz_timer/48MHz_timer/TOP.SchDoc
钢网加工文档/48MHz1-4_TCXO.PcbDoc
钢网加工文档/PHASE_SHIFTER.PcbDoc
