lyy622516-web/clock-module/(commit log)

2026-10-31 Initial import of hardware project
    [3D_48MHz1-4_TCXO_2026-10-30.step, 48MHz1-4_TCXO.PcbDoc, 48MHz_TCXO.SchDoc, 48MHz_timer.PrjPcb, 5PB1214CMGK8.PrjPcb, 5PB1214CMGK8.pcbdoc, 5PB1214CMGK8.schdoc, BS_RFE_BB_20230506.PcbLib]
2026-11-03 Add separate clock enclosure manufacturing and assembly packages
